Ritik440/Data-acquisition-system-using-stm32/P1.png

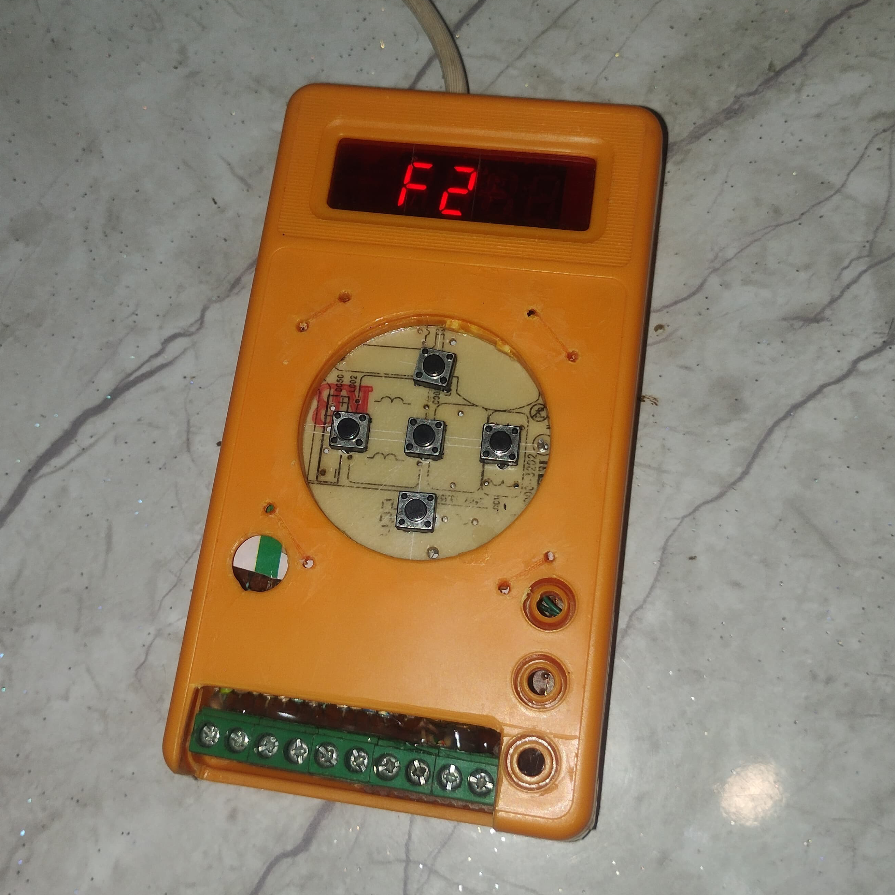
P1.png
